OpenScienceTools/DI-Lambda/(list of files, cad)

Other CAD files:
parts/Common/A4-paper.ipt
parts/Common/Cuvette.ipt
parts/Common/LCD12864-large-film.ipt
parts/Common/LCD12864-large.ipt
parts/Common/LCD12864.ipt
parts/Common/LCD5110.ipt
parts/Common/LED.ipt
parts/Common/LED_support.ipt
parts/Common/Microcontroller_board_Nano_square.iam
parts/Common/Microcontroller_board_Nano_square.ipt
parts/Common/Mini_USB_cable.ipt
parts/Common/Paper-holder-clip.ipt
parts/Common/Paper-holder.iam
parts/Common/Paper-holder.ipt
parts/Common/Pin-connector-angled-4.iam
parts/Common/Pin-connector-angled.ipt
parts/Common/Pin-round-2.54-female.ipt
parts/Common/Pin-round-2.54-male.ipt
parts/Common/SSM-101-F-DH.ipt
parts/Common/SZOMK-AK-C-C10.ipt
parts/Common/SZOMK-AK-C-C39.ipt
parts/Common/Slit_insert.ipt
parts/Common/Support_washer.ipt
parts/Common/fciconnect-10118194.ipt
parts/Common/fciconnect-91601-304.ipt
parts/Common/filter.ipt
parts/Luna/Assembly.iam
parts/Luna/Luna_base.ipt
parts/Luna/Luna_core.ipt
parts/Paris/Assembly.iam
parts/Paris/Assembly1.iam
parts/Paris/Assembly_smooth.iam
parts/Paris/Box2_bottom.ipt
parts/Paris/Box2_spacer.ipt
parts/Paris/Box2_top.ipt
parts/Paris/Box2_walls.ipt
parts/Paris/Box_back_wall.ipt
parts/Paris/Box_bottom.ipt
parts/Paris/Box_front_wall.ipt
parts/Paris/Box_left_wall.ipt
parts/Paris/Box_right_wall.ipt
parts/Paris/Box_top.ipt
parts/Paris/Core_bottom-im.ipt
parts/Paris/Core_bottom.ipt
parts/Paris/Core_top-im.ipt
parts/Paris/Core_top.ipt
parts/Paris/LED_board.ipt
parts/Paris/Microcontroller_board_Paris.iam
parts/Paris/Microcontroller_board_Paris.ipt
parts/Paris/Pinhole_insert_1mm_3x.ipt
parts/Paris/Sensor_board.ipt
parts/Paris/pinhole.ipt
parts/Spirulina/Assembly.iam
parts/Spirulina/Distance_test_adaptor_circle_1mm.ipt
parts/Spirulina/Spirulina_base.ipt
parts/Spirulina/Spirulina_core.ipt
parts/Test/Assembly.iam
parts/Test/Base.ipt
parts/Test/Distance_test_adaptor_circle_2mm.ipt
parts/Test/Distance_test_adaptor_slit_1mm.ipt
parts/Test/Distance_test_adaptor_slit_2mm.ipt
parts/Test/Distance_test_rig.ipt
parts/Test/LED_board.ipt
parts/Test/PCB_slit_circle_1.5mm.ipt
parts/Test/Sensor_board.ipt
parts/v1/AK-C-C10/AK-C-C10-Bottom.ipt
parts/v1/AK-C-C10/AK-C-C10-Insert-Board.ipt
parts/v1/AK-C-C10/AK-C-C10-LED-Board-Assembly.iam
parts/v1/AK-C-C10/AK-C-C10-LED-Board.ipt
parts/v1/AK-C-C10/AK-C-C10-Left_wall.ipt
parts/v1/AK-C-C10/AK-C-C10-Main-Board.ipt
parts/v1/AK-C-C10/AK-C-C10-Pinhole-Board.ipt
parts/v1/AK-C-C10/AK-C-C10-Right_wall.ipt
parts/v1/AK-C-C10/AK-C-C10-Sensor-Board.ipt
parts/v1/AK-C-C10/AK-C-C10-Separator.ipt
parts/v1/AK-C-C10/AK-C-C10-Top.ipt
parts/v1/AK-C-C10/AK-C-C10-Vertical.iam
parts/v1/AK-C-C10/SZOMK-AK-C-C10-Walls.iam
parts/v1/AK-C-C10/SZOMK-AK-C-C10-flat-plate.ipt
parts/v1/AK-C-C39/AK-C-C39-Bottom.ipt
parts/v1/AK-C-C39/AK-C-C39-Box.ipt
parts/v1/AK-C-C39/AK-C-C39-DI-Lambda-v1.iam
parts/v1/AK-C-C39/AK-C-C39-Holder-IM.ipt
parts/v1/AK-C-C39/AK-C-C39-Holder.ipt
parts/v1/AK-C-C39/AK-C-C39-Insert-Board.ipt
parts/v1/AK-C-C39/AK-C-C39-LED-Board-Assembly.iam
parts/v1/AK-C-C39/AK-C-C39-LED-Board-Assembly2.iam
parts/v1/AK-C-C39/AK-C-C39-LED-Board.ipt
parts/v1/AK-C-C39/AK-C-C39-LED-Carrier-Board.ipt
parts/v1/AK-C-C39/AK-C-C39-LED-Module.iam
parts/v1/AK-C-C39/AK-C-C39-Large-side.ipt
parts/v1/AK-C-C39/AK-C-C39-Main-Board.ipt
parts/v1/AK-C-C39/AK-C-C39-Pinhole-Board.ipt
parts/v1/AK-C-C39/AK-C-C39-Sensor-Board.ipt
parts/v1/AK-C-C39/AK-C-C39-Separator-usb.ipt
parts/v1/AK-C-C39/AK-C-C39-Separator.ipt
parts/v1/AK-C-C39/AK-C-C39-Small-side.ipt
parts/v1/AK-C-C39/AK-C-C39-Top.ipt
parts/v1/AK-C-C39/AK-C-C39-USB-Board-Assembly.iam
parts/v1/AK-C-C39/Ak-C-C39-USB-board.ipt
parts/v1/AK-C-C39/LCD.ipt
parts/v1/AK-C-C39/LED_module.ipt
