OpenScienceTools/DI-Lambda/schematics/Sensor-Board-LTR329-3x-v1/Sensor-Board-LTR329-3x.kicad_pcb

## KiCad design schematics/Sensor-Board-LTR329-3x-v1/Sensor-Board-LTR329-3x.kicad_pcb (2016-07-03)

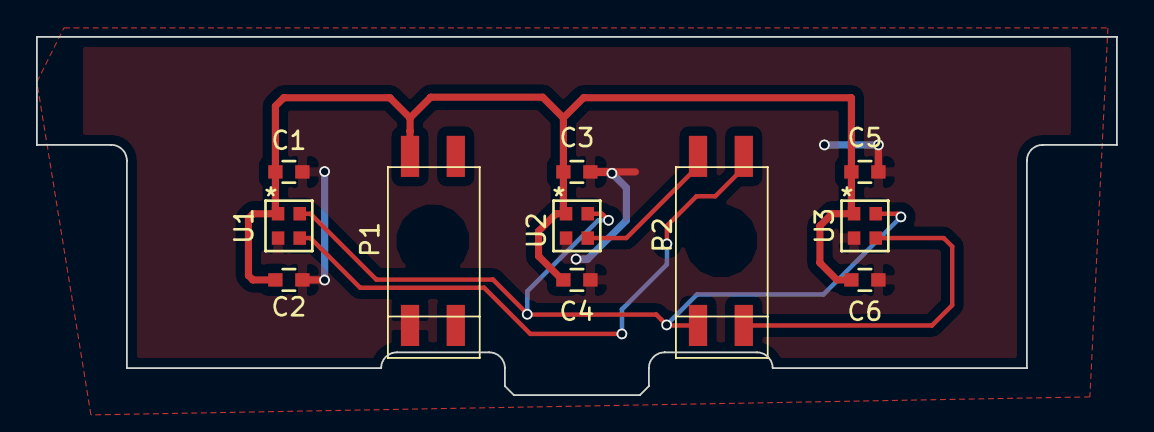
[picture p1: board Sensor-Board-LTR329-3x.kicad_pcb from above]

Board: 2 copper layers, 60.0 x 19.9 mm, 11 parts (0 on the bottom side), 6 nets.

Parts:
C1, C3, C5: 22nF; C_0603
C2, C4, C6: 1uF; C_0603
P1, P2: CONN_02X02; SSM-102-X-DH
U1, U2, U3: LTR-329ALS-01; Liteon_ChipLED

Connections:
GND: C1.2, C2.2, C3.2, C4.2, C5.2, C6.2, P1.1, U1.2, U2.2, U3.2
SCL: P2.1, U1.4, U2.4, U3.4
SDA0: P2.4, U1.3
SDA1: P2.2, U2.3
SDA2: P2.3, U3.3
VDD: C1.1, C2.1, C3.1, C4.1, C5.1, C6.1, P1.2, U1.1, U2.1, U3.1
