OpenScienceTools/DI-Lambda/schematics/LED-Board-Module/LED-Board-Module.kicad_pcb

## KiCad design schematics/LED-Board-Module/LED-Board-Module.kicad_pcb (2016-07-03)

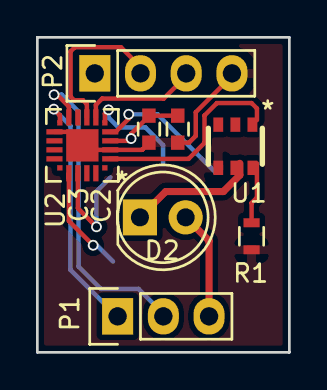
[picture p2: board LED-Board-Module.kicad_pcb from above]

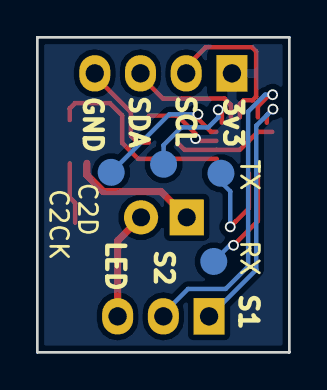
[picture p3: board LED-Board-Module.kicad_pcb from below]

Board: 2 copper layers, 14.0 x 17.5 mm, 12 parts (4 on the bottom side), 14 nets.

Parts:
C2: 1uF; C_0603
C3: 100nF; C_0603
D2: LED; LED-5MM
P1: CONN_01X03; Pin_Header_Straight_1x03
P2: CONN_01X04; Pin_Header_Straight_1x04
R1: 96R; R_0603
U1: BCR42XU; SOT26
U2: EFM8BB10F2G; Silabs-QFN20
W1: TX; TEST_POINT
W6: RX; TEST_POINT
W7: C2CK; TEST_POINT
W8: C2D; TEST_POINT

Connections:
CTRL: U1.1, U2.2
GND: C2.2, C3.2, P2.4, R1.1, U1.4, U2.3, U2.12, U2.21
LED: D2.2, P1.3
unnamed: D2.1, U1.5
unnamed: R1.2, U1.6
unnamed: U2.5, W7.1
unnamed: U2.6, W8.1
unnamed: U2.17, W6.1
unnamed: U2.18, W1.1
S1: P1.1, U2.11
S2: P1.2, U2.10
SCL: P2.2, U2.8
SDA: P2.3, U2.7
VDD: C2.1, C3.1, P2.1, U2.4
