OpenScienceTools/DI-Lambda/schematics/Controller-efm32hg308/Controller-efm32hg308.kicad_pcb

## KiCad design schematics/Controller-efm32hg308/Controller-efm32hg308.kicad_pcb (2016-07-03)

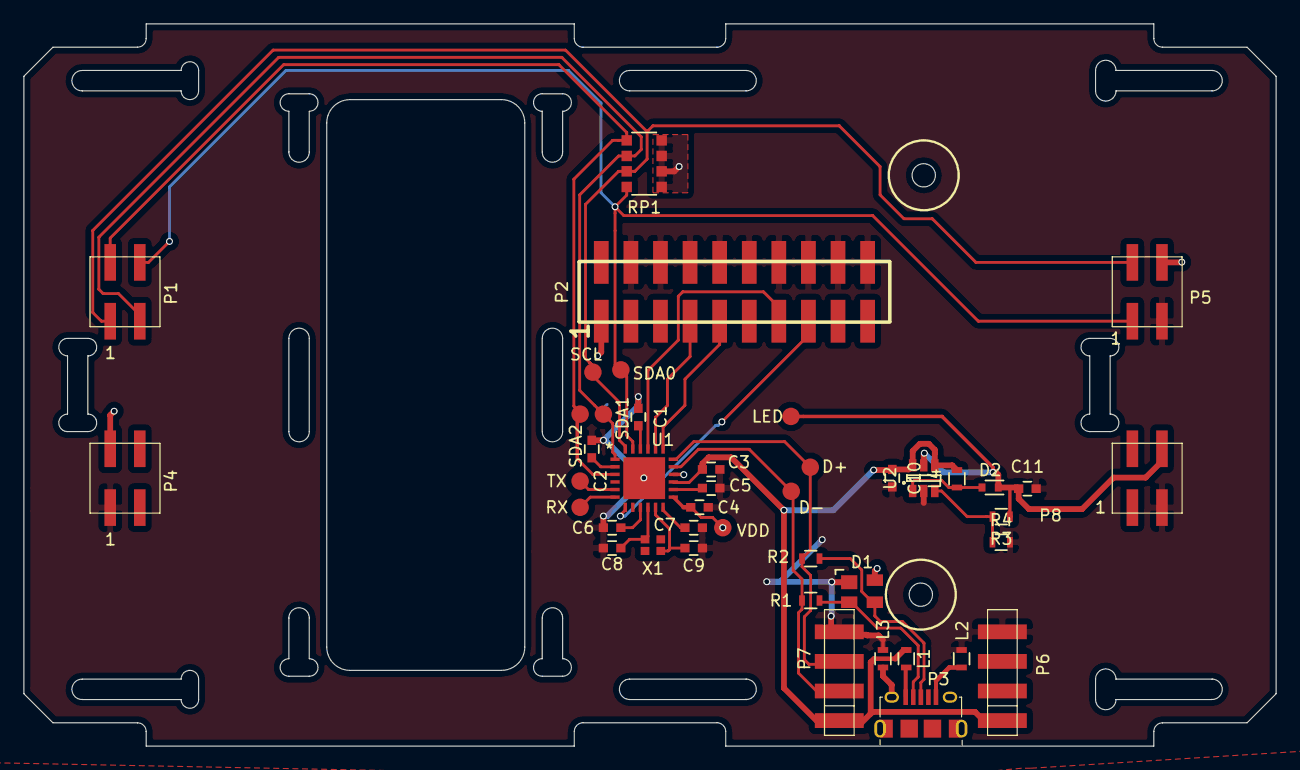
[picture p4: board Controller-efm32hg308.kicad_pcb from above]

Board: 2 copper layers, 107.5 x 62.0 mm, 43 parts (0 on the bottom side), 30 nets.

Parts:
C1, C2, C6, C7: 100nF; C_0603
C3: 4.7uF; C_0603
C4, C5, C11: 1uF; C_0603
C8, C9: 6pF; C_0603
C10: 10uF; C_0603
D1: CM1293A-02SR; SOT-143
D2: D_Schottky; SOD-523
L1, L2, L3: FB; R_0603
L4: 6.8uH; R_0603
P1, P4, P5, P8: CONN_02X02; CONN_2x2_2.54_SMD
P2: CONN_02X10; SMD_PIN_HEADER_2x10
P3: USB_OTG; 10118194-001LF
P6, P7: CONN_01X04; SMT_CONN_01x04_2.54-91601
R1, R2: 15; R_0603
R3: 6.8K; R_0603
R4: 100R; R_0603
RP1: 4.7k; R_Array_Convex_4x1206
U1: EFM32HG308; Silabs-QFN24
U2: AP3023; SOT-23-6
W1: D+; TEST_POINT
W2: D-; TEST_POINT
W3: LED; TEST_POINT
W4: VDD; TEST_POINT
W5: SCL; TEST_POINT
W6: SDA0; TEST_POINT
W7: SDA1; TEST_POINT
W8: SDA2; TEST_POINT
W9: TX; TEST_POINT
W10: RX; TEST_POINT
X1: XRCGB_F_L

Connections:
D+: P7.3, R2.2, U1.18, W1.1
D-: P7.2, R1.2, U1.17, W2.1
GND: C1.1, C2.2, C3.1, C4.2, C5.2, C6.2, C7.2, C8.2, C9.2, C10.2, C11.2, D1.1, L2.1, L3.1, P2.4, P2.6, P2.8, P2.10, P2.12, P2.14, P2.16, P2.18, P2.20, P4.1, P5.3, P6.4, P7.4, P8.3, R4.2, U1.25, U2.2
LED: C11.1, D2.1, P8.4, R3.1, U2.5, W3.1
unnamed: C1.2, U1.22
unnamed: C2.1, U1.2
unnamed: C5.1, U1.14
unnamed: C6.1, U1.9
unnamed: C7.1, U1.12
unnamed: C8.1, U1.10, X1.1
unnamed: C9.1, U1.11, X1.3
unnamed: D1.2, P3.2, R1.1
unnamed: D1.3, P3.3, R2.1
unnamed: D2.2, L4.1, U2.1
unnamed: L1.1, P3.1
unnamed: L2.2, P3.5
unnamed: L3.2, P3.6
unnamed: P2.7, U1.20
unnamed: P2.9, U1.19
unnamed: P2.13, U1.21
unnamed: R3.2, R4.1, U2.3
unnamed: U1.5, W9.1
unnamed: U1.6, W10.1
RESETn: P2.15, U1.7
SCL: P1.1, P5.2, RP1.7, U1.24, W5.1
SDA0: P1.4, P5.1, RP1.8, U1.23, W6.1
SDA1: P1.3, RP1.6, U1.1, W7.1
SDA2: P1.2, RP1.5, U1.3, W8.1
VBUS: C3.2, C10.1, L1.2, L4.2, P6.1, P7.1, U1.15, U2.4, U2.6
VDD: C4.1, D1.4, P2.1, P4.2, P5.4, RP1.1, RP1.2, RP1.3, RP1.4, U1.13, U1.16, W4.1
