OpenScienceTools/DI-Lambda/schematics/LED-Board-3x-Carrier/LED-Board-3x-Carrier.kicad_pcb

## KiCad design schematics/LED-Board-3x-Carrier/LED-Board-3x-Carrier.kicad_pcb (2016-07-03)

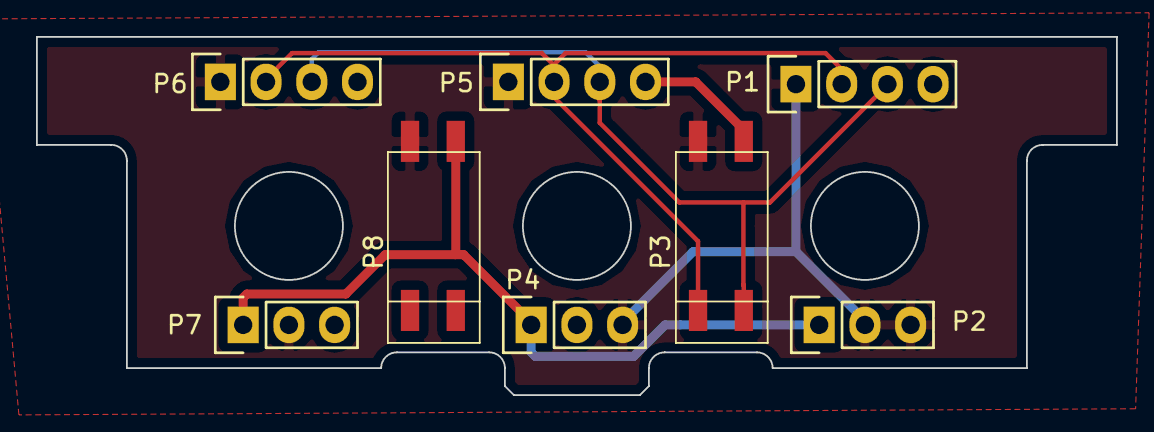
[picture p5: board LED-Board-3x-Carrier.kicad_pcb from above]

Board: 2 copper layers, 60.0 x 19.9 mm, 8 parts (0 on the bottom side), 5 nets.

Parts:
P1, P5, P6: CONN_01X04; Socket_Strip_Straight_1x04
P2, P4, P7: CONN_01X03; Socket_Strip_Straight_1x03
P3, P8: CONN_02X02; SSM-102-X-DH

Connections:
GND: P1.1, P2.2, P2.3, P3.2, P4.3, P5.1, P6.1, P7.2, P8.2
LED: P2.1, P4.1, P7.1, P8.4
SCL: P1.3, P3.3, P5.3, P6.3
SDA: P1.2, P3.1, P5.2, P6.2
VDD: P1.4, P3.4, P4.2, P5.4, P6.4, P7.3
