OpenScienceTools/DI-Lambda/schematics/USB-Board/USB-Board.kicad_pcb

## KiCad design schematics/USB-Board/USB-Board.kicad_pcb (2016-07-03)

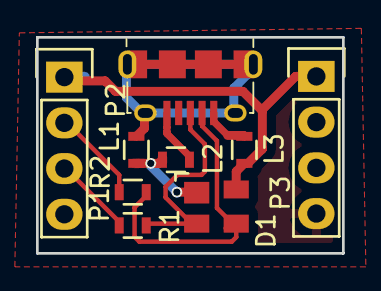
[picture p6: board USB-Board.kicad_pcb from above]

Board: 2 copper layers, 17.0 x 12.0 mm, 9 parts (0 on the bottom side), 9 nets.

Parts:
D1: CM1293A-02SR; SOT-143
L1, L2, L3: FB; R_0603
P1, P3: CONN_01X04; Pin_Header_Straight_1x04
P2: USB_OTG; 10118194-001LF
R1, R2: 15; R_0603

Connections:
D+: P1.3, R1.2
D-: P1.2, R2.2
GND: D1.1, L1.1, L2.1, P1.4, P3.4
unnamed: D1.2, P2.3, R1.1
unnamed: D1.3, P2.2, R2.1
unnamed: L1.2, P2.6
unnamed: L2.2, P2.5
unnamed: L3.1, P2.1
VCC: D1.4, L3.2, P1.1, P3.1
