OpenScienceTools/DI-Lambda/schematics/Controller-Bee/Controller-Bee-Paris-horizontal.kicad_pcb

## KiCad design schematics/Controller-Bee/Controller-Bee-Paris-horizontal.kicad_pcb (2016-05-24)

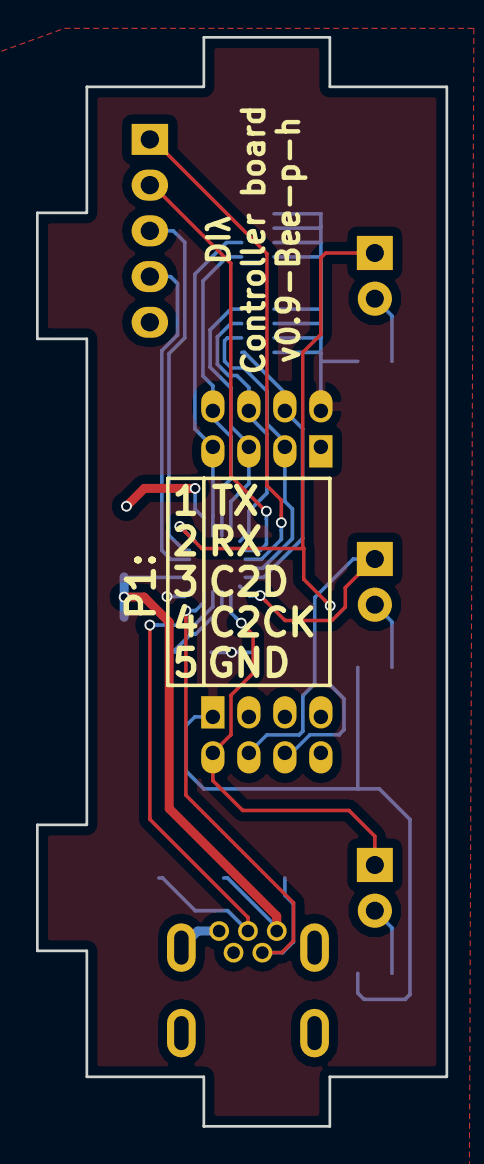
[picture p7: board Controller-Bee-Paris-horizontal.kicad_pcb from above]

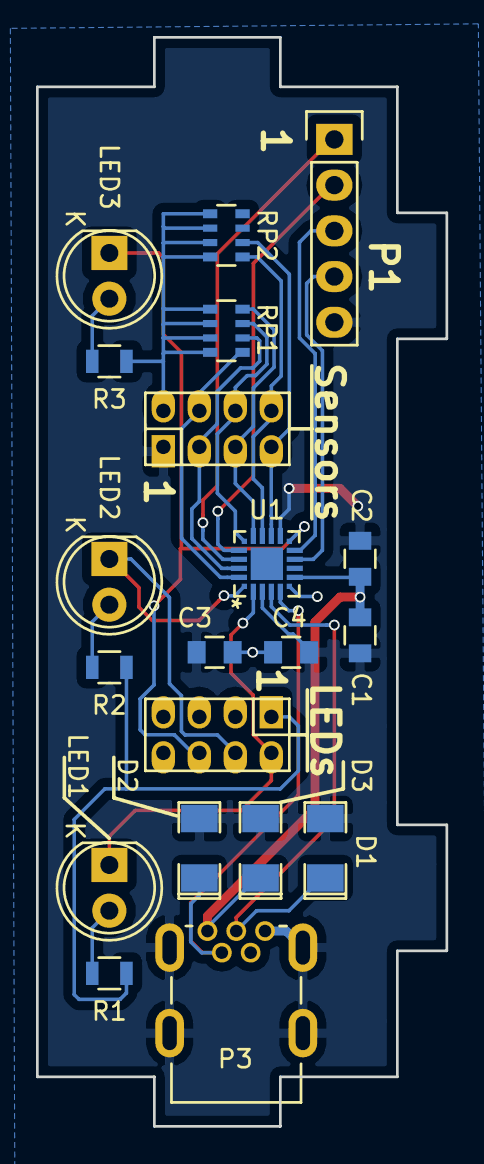
[picture p8: board Controller-Bee-Paris-horizontal.kicad_pcb from below]

Board: 2 copper layers, 22.8 x 60.5 mm, 20 parts (20 on the bottom side), 21 nets.

Parts:
C1, C3: 4.7uF; C_0805
C2: 100nf; C_0805
C4: 100nF; C_0805
D1, D2, D3: ZENER; SMD-1206_Pol
LED1, LED2, LED3: LED; LED-5MM
P1: CONN_01X05; Pin_Header_Straight_1x05
P2, P4: CONN_02X04; Pin_Header_Straight_2x04_Pitch2.00mm
P3: USB_OTG; USB-B-mini
R1, R2, R3: 220; R_0805
RP1, RP2: 4k7; R_Array_Convex_4x0603
U1: EFM8UB10F8G-B-QFN20; Silabs-QFN20

Connections:
/d+: D1.1, P3.3, U1.4
/d-: D2.1, P3.2, U1.5
C2CK: P1.4, U1.9
C2D: P1.3, U1.10
GND: C1.2, C2.2, C3.2, C4.2, D1.2, D2.2, D3.2, P1.5, P2.1, P3.5, P3.6, U1.3, U1.12
unnamed: C1.1, C2.1, D3.1, P3.1, U1.7
unnamed: LED1.2, R1.2
unnamed: LED2.2, R2.2
unnamed: LED3.2, R3.2
unnamed: P1.1, U1.18
unnamed: P1.2, U1.17
SC0: P2.4, RP1.1, U1.20
SC1: P2.6, RP1.3, U1.16
SC2: P2.8, RP2.1, U1.14
SD0: P2.3, RP1.2, U1.19
SD1: P2.5, RP1.4, U1.15
SD2: P2.7, RP2.2, U1.13
VDD: C3.1, C4.1, P2.2, P4.1, R1.1, R2.1, R3.1, RP1.5, RP1.6, RP1.7, RP1.8, RP2.5, RP2.6, RP2.7, RP2.8, U1.6
iLED1: LED1.1, P4.2, U1.2
iLED2: LED2.1, P4.4, U1.1
iLED3: LED3.1, P4.6, U1.11
