OpenScienceTools/DI-Lambda/schematics/Sensor-Board-LTR329-3x/Sensor-Board-LTR329-3x-1cm.kicad_pcb

## KiCad design schematics/Sensor-Board-LTR329-3x/Sensor-Board-LTR329-3x-1cm.kicad_pcb (2016-05-24)

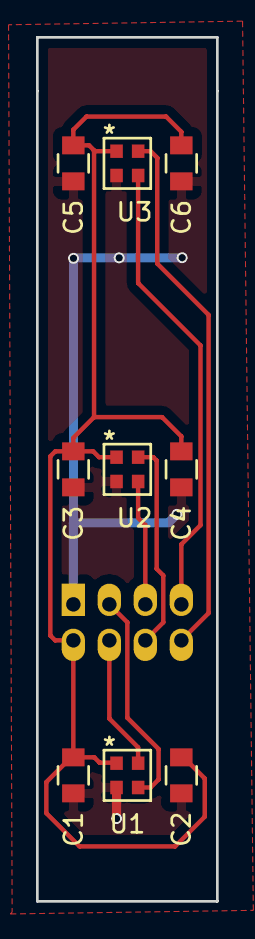
[picture p11: board Sensor-Board-LTR329-3x-1cm.kicad_pcb from above]

Board: 2 copper layers, 10.0 x 48.0 mm, 10 parts (1 on the bottom side), 8 nets.

Parts:
C1, C2, C3, C4, C5, C6: C; C_0805
P1: CONN_02X04; Pin_Header_Straight_2x04_Pitch2.00mm
U1, U2, U3: LTR-329ALS-01; Liteon_ChipLED

Connections:
+3V3: C1.1, C2.1, C3.1, C4.1, C5.1, C6.1, P1.2, U1.1, U2.1, U3.1
GND: C1.2, C2.2, C3.2, C4.2, C5.2, C6.2, P1.1, U1.2, U2.2, U3.2
SC0: P1.4, U1.4
SC1: P1.6, U2.4
SC2: P1.8, U3.4
SD0: P1.3, U1.3
SD1: P1.5, U2.3
SD2: P1.7, U3.3
