OpenScienceTools/DI-Lambda/schematics/Controller-Nano-i2c_mux/Controller-Nano-i2c_mux-Square.kicad_pcb

## KiCad design schematics/Controller-Nano-i2c_mux/Controller-Nano-i2c_mux-Square.kicad_pcb (2016-05-24)

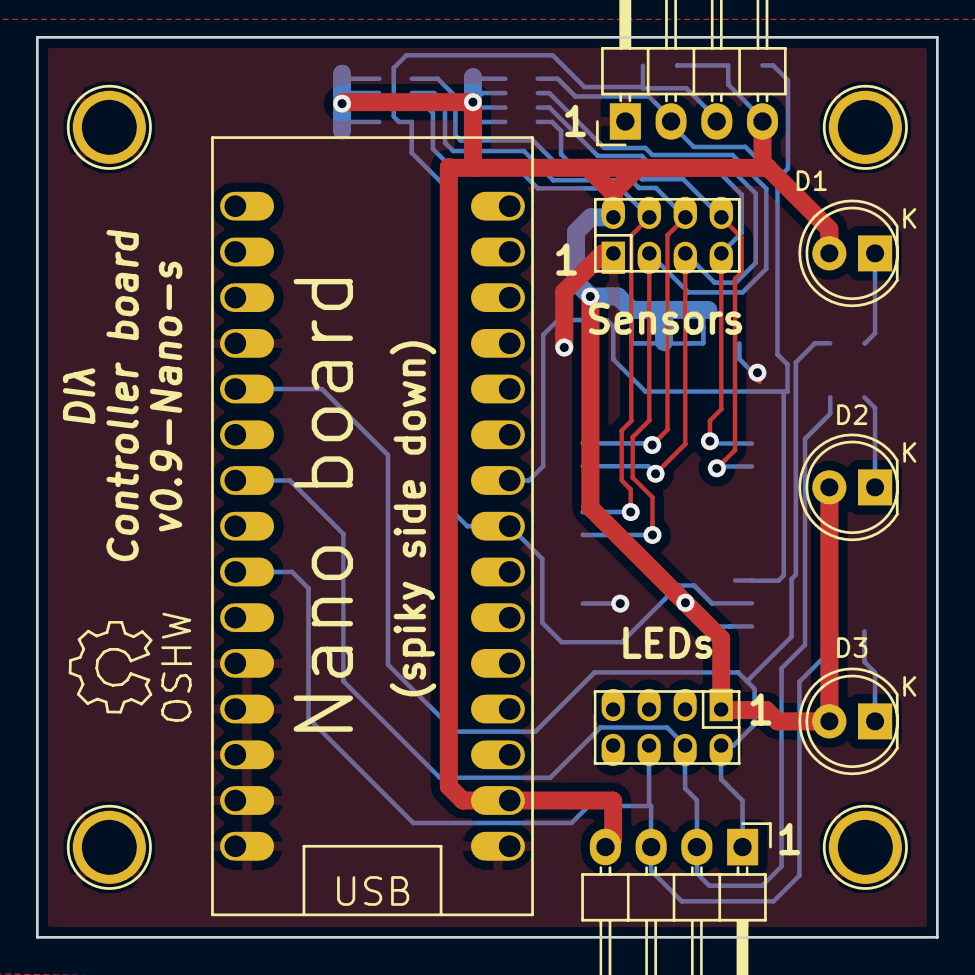
[picture p12: board Controller-Nano-i2c_mux-Square.kicad_pcb from above]

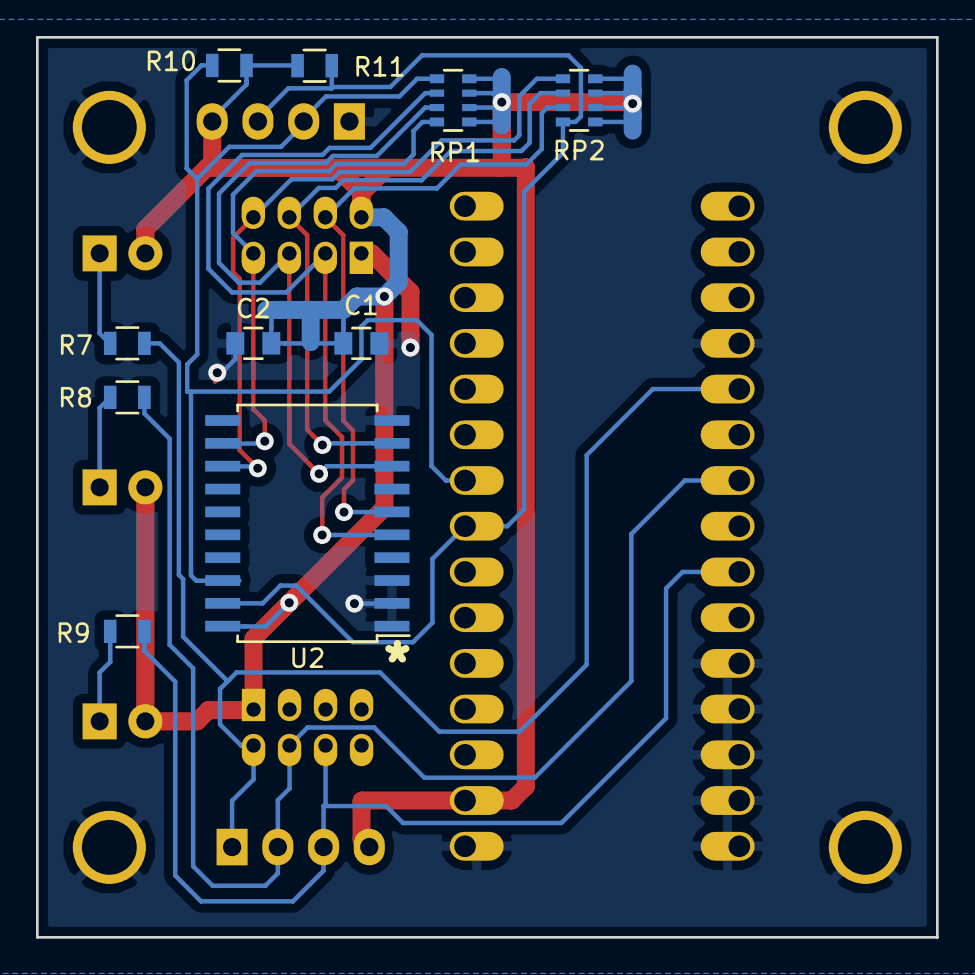
[picture p13: board Controller-Nano-i2c_mux-Square.kicad_pcb from below]

Board: 2 copper layers, 50.0 x 50.0 mm, 22 parts (10 on the bottom side), 16 nets.

Parts:
C1: 22nF; C_0805
C2: 1uF; C_0805
D1, D2, D3: LED; LED-5MM
P1, P2: CONN_02X04; Pin_Header_Straight_2x04_Pitch2.00mm
P3, P4: CONN_01X04; Pin_Header_Angled_1x04
P5, P6, P7, P8: CONN_01X01; 1pin
R7, R8, R9: 220; R_0805
R10, R11: 4k7; R_0805
RP1, RP2: R_PACK4; R_Array_Convex_4x0603
U1: Arduino_Nano; PDIP30-Nano
U2: PCA9544A; SOIC-20_7.5x12.8mm_Pitch1.27mm

Connections:
+3V3: C1.1, C2.1, D1.2, D2.2, D3.2, P1.2, P2.1, P3.4, P4.4, R10.2, R11.2, RP1.5, RP1.6, RP1.7, RP1.8, RP2.5, RP2.6, RP2.7, RP2.8, U1.17, U2.20
GND: C1.2, C2.2, P1.1, P4.1, P5.1, P6.1, P7.1, P8.1, U1.4, U1.11, U1.12, U1.13, U1.14, U1.15, U1.16, U2.1, U2.2, U2.3, U2.10
LED1: P2.2, P3.1, R7.2, U1.5
LED2: P2.4, P3.2, R8.2, U1.7
LED3: P2.6, P3.3, R9.2, U1.9
unnamed: D1.1, R7.1
unnamed: D2.1, R8.1
unnamed: D3.1, R9.1
SC0: P1.4, RP2.3, U2.6
SC1: P1.6, RP2.2, U2.9
SC2: P1.8, RP2.1, U2.13
SCL: P4.2, R10.1, RP1.1, U1.24, U2.18
SD0: P1.3, RP1.2, U2.5
SD1: P1.5, RP1.3, U2.8
SD2: P1.7, RP1.4, U2.12
SDA: P4.3, R11.1, RP2.4, U1.23, U2.19
