OpenScienceTools/DI-Lambda/schematics/LED-Board-3x/LED-Board-3x-1cm.kicad_pcb

## KiCad design schematics/LED-Board-3x/LED-Board-3x-1cm.kicad_pcb (2016-05-24)

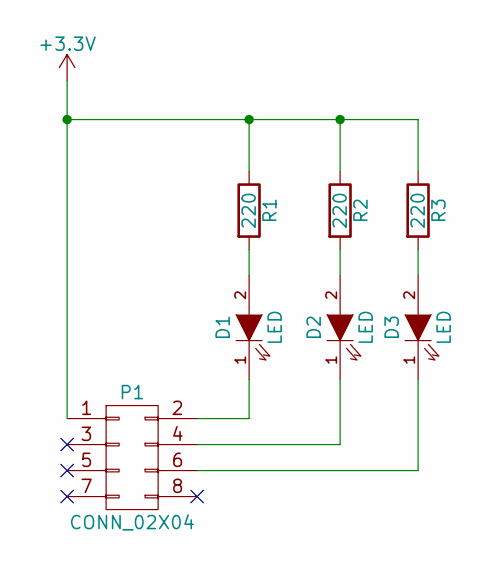
[picture p14: schematic LED-Board-3x-1cm.sch]

Parts:
D1, D2, D3: LED; LED-5MM
P1: CONN_02X04; Pin_Header_Straight_2x04_Pitch2.00mm
R1, R2, R3: 220; R_0805

Connections:
+3V3: P1.1, R1.1, R2.1, R3.1
unnamed: D1.1 (K), P1.2
unnamed: D1.2 (A), R1.2
unnamed: D2.1 (K), P1.4
unnamed: D2.2 (A), R2.2
unnamed: D3.1 (K), P1.6
unnamed: D3.2 (A), R3.2

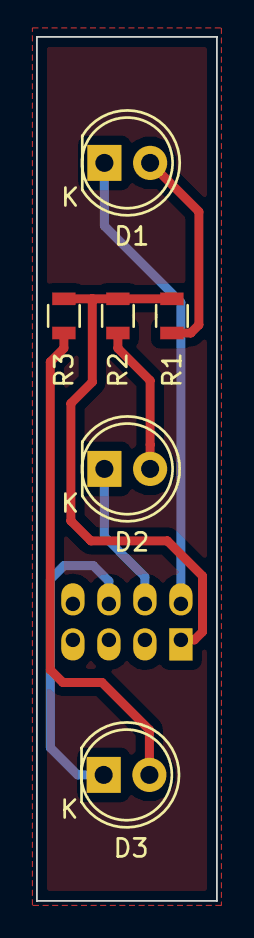
[picture p15: board LED-Board-3x-1cm.kicad_pcb from above]

Board: 2 copper layers, 10.0 x 48.0 mm, 7 parts (1 on the bottom side), 7 nets.
