OpenScienceTools/DI-Lambda/(commit log)

2014-12-25 Some unfinished schematics
    [LED-board.brd, LED-board.sch, Mother-board.sch, Sensor-board.brd, Sensor-board.sch]
2014-12-25 Add some unfinished parts
    [Base_V1.ipt, Board_V1.ipt, Led_Board_V1.ipt]
2014-12-25 Finish up the fist version, excluding the top part
    [Assembly.iam, Led_Board_V1.ipt, Motherboard_dummy.ipt, Sensor_Board_dummy.ipt, filter.ipt]
2014-12-25 Render assembly
    [Base_V1.ipt]
2014-12-25 Some progress with schematics
    [Mother-board.sch, Sensor-board.brd, Sensor-board.sch]
2014-12-25 Add stl exports for 3d printing
    [Base_V1.stl, Led_Board_V1.stl, Motherboard_dummy.stl, Sensor_Board_dummy.stl]
2014-12-25 Add the top part of the box
    [Top.ipt]
2014-12-25 Some updates
    [Assembly.iam, Led_Board_V1.ipt, Sensor_Board_dummy.ipt]
2014-12-30 More detailed leds on the lead board
    [Led_Board_V1.ipt, Led_Board_V1.stl]
2014-12-30 Second version base part
    [Base_V2.ipt, Base_V2.stl]
2014-12-30 Second version of the top part
    [TopV2.ipt]
2014-12-30 stl export for the second version top part
    [TopV2.stl]
2014-12-30 Add cuvette model
    [Cuvette.ipt]
2014-12-31 Smaller motherboard, dimension changes to allow some gap betwen parts
    [Assembly.iam, Base_V2.ipt, Led_Board_V1.ipt, Motherboard_dummy.ipt, Sensor_Board_dummy.ipt, TopV2.ipt]
2014-12-31 Add the cover part
    [Cover.ipt, Cover.stl]
2014-12-31 Accomodate top part for the cover
    [TopV2.ipt, TopV2.stl]
2014-12-31 Some changes here and there
    [Assembly.iam, Base_V2.ipt, Led_Board_V1.ipt, Sensor_Board_dummy.ipt, TopV2.ipt]
2014-12-31 Some changes
    [Assembly.iam, Base_V2.ipt, Led_Board_V1.ipt, Sensor_Board_dummy.ipt, TopV2.ipt, TopV2.stl]
2015-01-06 Reworked some schematics
    [LED-board.brd, LED-board.sch, Mother-board.sch, Sensor-board.brd]
2015-01-06 Rework bottom part to optimize size
    [Assembly.iam, Base_V2.ipt, Base_V2.stl, Cuvette.ipt, Motherboard_dummy.ipt, Motherboard_dummy.stl, TopV2.ipt, TopV2.stl]
2015-01-06 Bottom part sketch
    [TopV2.ipt]
2015-01-07 Finish the size rework
    [Assembly.iam, Base_V2.ipt, Cover.ipt, Led_Board_V1.ipt, Sensor_Board_dummy.ipt, TopV2.ipt, TopV2.stl]
2015-01-11 Add assembly render pictures
2015-01-13 A last-minute commit before leaving for Grenoble
    [Assembly.iam, Base_V2.ipt, Base_V2.stl, Cover.ipt, Cuvette.ipt, LED-board.brd, LED-board.sch, Led_Board_V1.ipt]
2015-02-03 New partially laser-cut version
    [Assembly2.iam, Base_V3.ipt, Base_V3.stl, Bask_Wall.ipt, Bottom.ipt, Front_wall.ipt, LED_support.ipt, LED_support.stl]
2015-02-03 Add the laser-cut Autocad parts
    [Back_wall.dwg, Bottom_plate.dwg, Box.dwg, Box_1x.dwg, Front_wall.dwg, Left_wall.dwg, Right_wall.dwg, Top_plate.dwg]
2015-02-03 Just a quick fix
    [Top_V3.ipt, Top_V3.stl]
2015-06-03 Add the test rig, lots of other changes
    [Cuvette_cover.ipt, Cuvette_cover.stl, Cuvette_retainer.ipt, Cuvette_retainer.stl, Distance_test_adaptor_circle_1mm.ipt, Distance_test_adaptor_circle_1mm.stl, Distance_test_adaptor_circle_2mm.ipt, Distance_test_adaptor_circle_2mm.stl]
2015-06-03 Spirulina prototype
    [Spirulina_prototype.ipt, Spirulina_prototype.stl]
2015-06-12 Start with the new slim design
    [Assembly2.iam, Base_V3.ipt, Bask_Wall.ipt, Bottom.ipt, Bottom_V3.ipt, Cuvette_retainer.ipt, Cuvette_retainer.stl, Distance_test_rig.ipt]
2015-06-16 Some changes to parts used in the London event
    [Cuvette_retainer.ipt, Cuvette_retainer.stl, Distance_test_rig.ipt, Distance_test_rig.stl, Spirulina_prototype.ipt, Spirulina_prototype.stl]
2015-06-16 Convert laser-cut parts to AI
2015-06-24 DI-Lambda Paris
    [Assembly1.iam, Bottom_V3.ipt, Bottom_plate2.ipt, Cuvette_retainer.ipt, Cuvette_retainer.stl, Cuvette_retainer2.ipt, Distance_test_rig.ipt, Large_retainer.ipt]
2015-06-24 Align things to verify board dimensions
    [Assembly1.iam, LED.ipt, Left_wall.ipt, Motherboard_assembly.iam, Motherboard_dummy.ipt, Pin-connector-angled-4.iam, Right_wall.ipt, Top_plate2.ipt]
2015-06-29 DIL-Paris takes shape
    [Assembly1.iam, Back_Wall.ipt, Back_wall.dwg, Bottom_plate.dwg, Bottom_plate2.ipt, Distance_test_rig.ipt, Distance_test_rig.stl, Front_wall.dwg]
2015-07-14 DI-Lambda Luna
    [Assembly1.iam, DIL-Luna.dwg, Luna.ipt, Top_V4.ipt]
2015-07-19 Steps towards a screwless case for DI-Lambda Paris
    [Assembly1.iam, Bottom_plate2.ipt, Front_wall.ipt, Left_wall.ipt, Right_wall.ipt, Top_plate2.ipt]
2015-07-19 Large git repo cleanup - move files around, remove unused
    [Assembly.iam, Assembly2.iam, Back_wall.dwg, Base.ipt, Base_V1.ipt, Base_V1.stl, Base_V2.ipt, Base_V2.stl]
2015-07-19 Large git repo cleanup - update assemblies
    [Assembly.iam, LED_board.ipt, Microcontroller_board_assumbly.iam, Sensor_board.ipt]
2015-07-20 Spirulina: Add missing 1mm slit
    [Distance_test_adaptor_circle_1mm.ipt]
2015-07-20 Paris: First attempt on screwless box
    [Assembly.iam, Box_back_wall.ipt, Box_bottom.ipt, Box_front_wall.ipt, Box_left_wall.ipt, Box_top.ipt, Microcontroller_board_assumbly.iam]
2015-07-21 Clean up the screwless box design
    [Assembly.iam, Box_bottom.ipt, Box_top.ipt]
2015-08-01 Update screwless box design and rework the controller board
    [Assembly.iam, Box_back_wall.ipt, Box_bottom.ipt, Box_front_wall.ipt, Box_left_wall.ipt, Box_top.ipt, Core_bottom.ipt, Core_top.ipt]
2015-08-05 Assemblies for each device, to make nice pictures
    [Assembly.iam, Base.ipt, Core_bottom.ipt, Core_top.ipt, Cuvette.ipt, Distance_test_adaptor_circle_2mm.ipt, Distance_test_rig.ipt, LED.ipt]
2015-08-07 Remove old schematics
    [LED-board.brd, LED-board.sch, Mother-board.sch, Sensor-board.brd, Sensor-board.sch]
2015-08-15 New slit inserts for the test rig
    [Assembly.iam, Base.ipt, Distance_test_rig.ipt, PCB_slit_circle_1.5mm.ipt]
2015-08-19 All new schematics and boards
    - Reworked with KiCad
    - Includes:
    -- 2 Microcontroller board with Arduino Nano
    -- Microcontroller board with the Silabs EFM8UB10F8G MCU
    -- 1cm LED board
    -- 1cm sensor board with TSL2561
    -- 1cm sensor board with LTR-329ALS
    [Controller-Bee-Paris-horizontal.kicad_pcb, Controller-Bee-Paris-horizontal.sch, Controller-Bee.sch, Controller-Nano-i2c_mux-Paris.kicad_pcb, Controller-Nano-i2c_mux-Paris.sch, Controller-Nano-i2c_mux-Square.kicad_pcb, Controller-Nano-i2c_mux-Square.sch, Controller-Nano-i2c_mux.sch]
2015-08-20 schematics: update LED connections, use 4x resistor arrays
    [Controller-Bee-Paris-horizontal.kicad_pcb, Controller-Bee.sch, Controller-Nano-i2c_mux-Paris.kicad_pcb, Controller-Nano-i2c_mux-Square.kicad_pcb, Controller-Nano-i2c_mux.sch, LED-Board-3x-1cm.kicad_pcb, LED-Board-3x-1cm.sch, LED-Board-3x.sch]
2016-03-11 Large amount of random changes
    [A4-paper.ipt, Assembly.iam, Assembly1.iam, Assembly_smooth.iam, Base.ipt, Box_back_wall.ipt, Box_bottom.ipt, Box_front_wall.ipt]
2016-05-24 Update the DI-Lambda Paris design: PCB pinholes, easier board removal, larger cuvette holes
    [A4-paper.ipt, Assembly.iam, Core_bottom-im.ipt, Core_top-im.ipt, Cuvette.ipt, LED.ipt, Microcontroller_board_Paris.iam, Paper-holder-clip.ipt]
2016-05-24 Add missing files for the nice-looking DI-Lambd Paris v2 version (cancelled)
    [Box2_bottom.ipt, Box2_spacer.ipt, Box2_top.ipt, Box2_walls.ipt]
2016-05-24 Add DI-Lambda v1 based on SZOMK AK-C-C10 profile (cancelled)
    [AK-C-C10-Bottom.ipt, AK-C-C10-Insert-Board.ipt, AK-C-C10-LED-Board-Assembly.iam, AK-C-C10-LED-Board.ipt, AK-C-C10-Left_wall.ipt, AK-C-C10-Main-Board.ipt, AK-C-C10-Pinhole-Board.ipt, AK-C-C10-Right_wall.ipt]
2016-05-24 Add DI-Lambda v1 based on SZOMK AK-C-C39 profile
    [AK-C-C39-Bottom.ipt, AK-C-C39-Box.ipt, AK-C-C39-DI-Lambda-v1.iam, AK-C-C39-Holder-IM.ipt, AK-C-C39-Holder.ipt, AK-C-C39-Insert-Board.ipt, AK-C-C39-LED-Board-Assembly.iam, AK-C-C39-LED-Board.ipt]
2016-05-24 Schematics update
    [Controller-Bee-Paris-horizontal.kicad_pcb, Controller-Nano-i2c_mux-Paris.kicad_pcb, Controller-Nano-i2c_mux-Paris.sch, Controller-Nano-i2c_mux-Square.kicad_pcb, Controller-Nano-i2c_mux.sch, LED-Board-3x-1cm.kicad_pcb, LED-Board-3x.sch, Sensor-Board-LTR329-3x-1cm.kicad_pcb]
2016-05-24 DI-Lambda Paris: Fix core and box mismatches
    [Assembly.iam, Box_bottom.ipt, Box_front_wall.ipt, Box_left_wall.ipt, Box_top.ipt, Core_top-im.ipt]
2016-05-24 Schamatics: Add the pinhole board KiCad files
    [pinholes.kicad_pcb, pinholes.sch]
2016-07-03 Electronics update for V1
    [Controller-efm32hg308.kicad_pcb, Controller-efm32hg308.sch, LED-Board-3x-Carrier.kicad_pcb, LED-Board-3x-Carrier.sch, LED-Board-Module.kicad_pcb, LED-Board-Module.sch, Sensor-Board-LTR329-3x.kicad_pcb, Sensor-Board-LTR329-3x.sch]
2016-07-03 Update V1 mechanical parts
    [AK-C-C39-Bottom.ipt, AK-C-C39-DI-Lambda-v1.iam, AK-C-C39-Holder-IM.ipt, AK-C-C39-Holder.ipt, AK-C-C39-Insert-Board.ipt, AK-C-C39-LED-Board-Assembly.iam, AK-C-C39-LED-Board-Assembly2.iam, AK-C-C39-LED-Board.ipt]
